VytorCalixto/Killer/(commit log)

2015-03-20 adding revision 106 from Sourceforge
    [tb_cMIPS.csv]
2015-04-10 fixed UART; added tx-test program
    [mac_uart_rx.c, mac_uart_tx.c]
2015-04-29 moved remota into uart.vhd
2015-04-29 core with TLB skeleton 4th fix
    [packageWires.vhd]
2015-05-17 fixes to overflow detection
    [core.vhd, exception.vhd]
2015-05-17 adjusted gtkwave config files for UART experiments
2015-05-19 two fixes to UART experiments
    [uarttx.c]
2015-05-19 new fixes to UART experiments
2015-05-22 fixes to trap handling
    [core.vhd, exception.vhd, packageMemory.vhd]
2015-05-25 Adicionado arquivo em C p/ testar a UART e adicionada a parte de leitura de dados no handler
2015-05-27 Adicionado UartControl
2015-05-28 Adicionada funções getc e putc (uart_putc)
2015-05-29 UART data structure Ud
2015-05-30 UART code with Tstatus plus better TLB init mappings
2015-06-03 Implementada parte de recepção do handler (incompleto)
2015-06-03 Implementadas funções proberx e probetx
2015-06-05 Trying to write first character directly on UART to generate first interruption
2015-06-09 Fixed access to Ud on handlerUART.s and initialized Ud variables on uart.c
    [uart.c]
2015-06-15 Transmission almost complete. It works, but still has some problems
    [uart.c]
2015-06-17 Insertion sort and convertion from integer to char
2015-06-20 Everything works! Transmission fixed, missing functions implemented and uart.c code refactored to use these functions
    [uart.c]
2015-06-21 Sorting and printing order changed
    Sorting now occurs when getting a char
    Data is now sent in ascending order
